johncohn/alia_blinky/SOLDER.md

# Soldering and Gluing the Alia Blinky PCB

This guide walks you through two assembly steps: soldering the Seeed XIAO RP2040 microcontroller onto the Alia Blinky PCB, and gluing the prop and tail diffuser covers in place. Soldering is optional — the board also works with the microcontroller plugged in via socket headers — but soldering it down gives a more secure, permanent connection.

**Time:** ~20 minutes  
**Skill level:** Beginner-friendly

## What You Need

- Alia Blinky PCB
- Seeed XIAO RP2040 (or compatible board)
- 2× 7-pin male header strips (usually included with the XIAO)
- Soldering iron (300°C / 570°F)
- Solder (rosin-core recommended)
- Isopropyl alcohol (IPA) + cotton swabs for cleanup
- Flush cutters + safety glasses for trimming pins
- Kapton or masking tape (optional, helps hold the chip while soldering the back)

## Step 1: Get familiar with the PCB

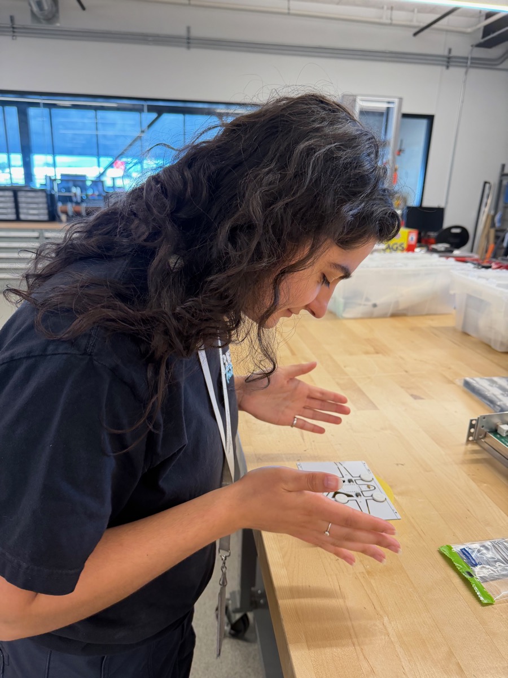
[picture p6: images/soldering/IMG_4557.jpeg]
Person examining the PCB


Take a moment to look over the PCB. The center area is where the microcontroller mounts. The large circular pads are the prop LED pads; the gold traces connect everything together.

## Step 2: Inspect the PCB component side

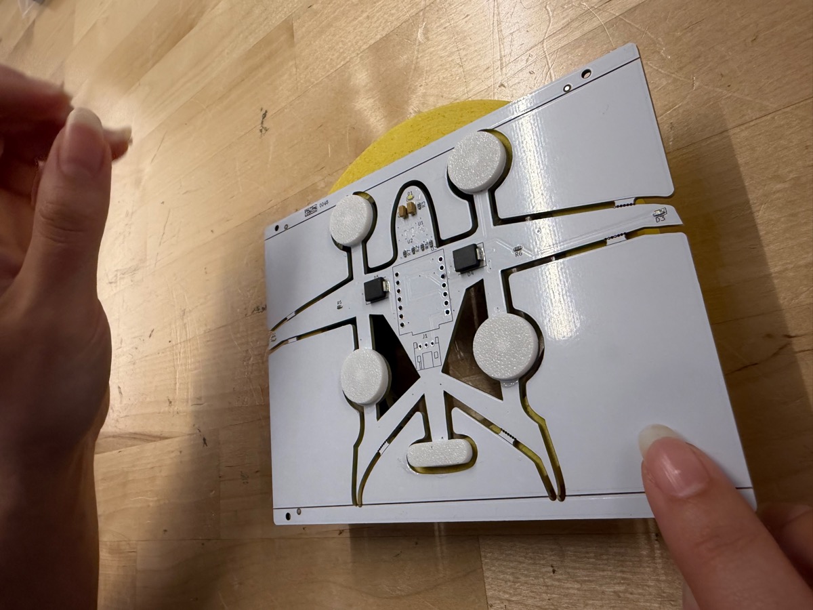
[picture p7: images/soldering/IMG_4558.jpeg]
PCB front side showing component area


The front side of the PCB has the small pre-soldered SMD components (capacitors, diodes, resistors) in the center. The two rows of through-holes flanking the center cutout are where the pin headers will go.

## Step 3: Gather your parts

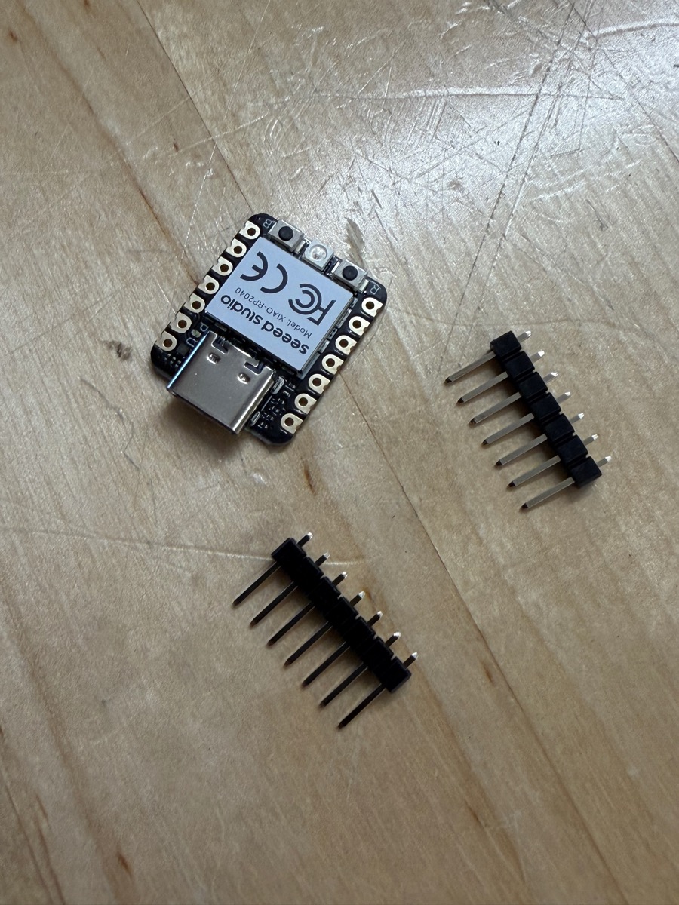
[picture p8: images/soldering/IMG_4563.jpeg]
XIAO RP2040 with two pin header strips


You need the XIAO RP2040 and two 7-pin header strips. The headers typically come packaged with the XIAO — break them to length if needed.

## Step 4: Insert the pin headers

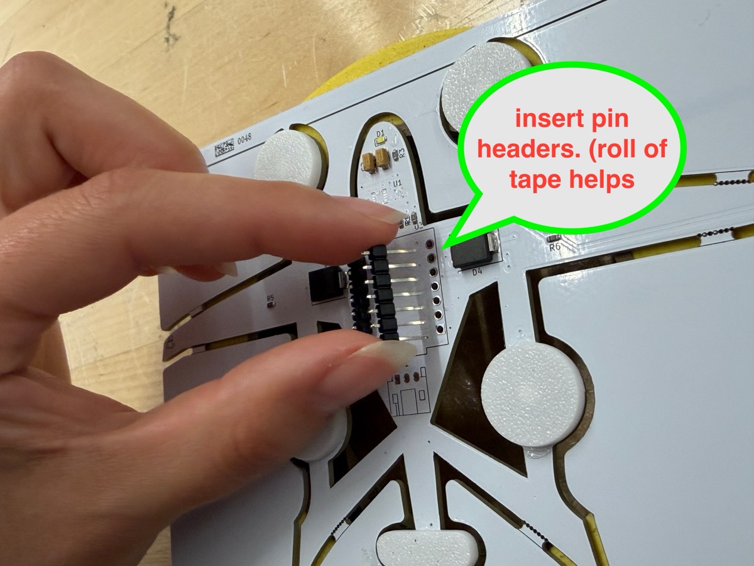
[picture p9: images/soldering/IMG_4566.jpeg]
Inserting pin headers into PCB


Insert the two pin header strips into the through-holes on the PCB (short pins down through the board, long pins up). **Tip:** resting the PCB on a roll of tape keeps it elevated so the pins don't get pushed back out while you work.

## Step 5: Pin headers seated

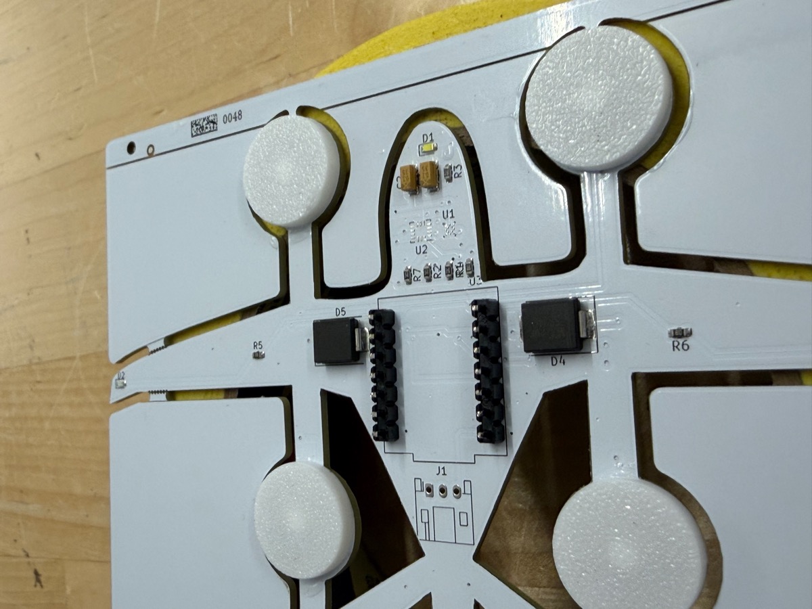
[picture p10: images/soldering/IMG_4568.jpeg]
PCB with pin headers inserted, center area visible


With both header strips inserted, you can see the two rows of pins ready to accept the microcontroller. The pre-soldered SMD components (D1, D4, D5, R5, R6, U1, U2) are visible in the center — these are already done for you.

## Step 6: Place the microcontroller — correct orientation

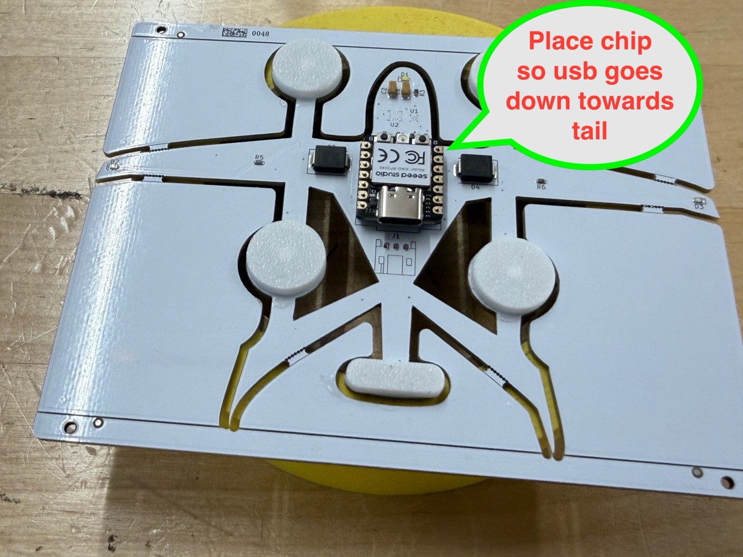
[picture p11: images/soldering/IMG_4570.jpeg]
XIAO placed on PCB, USB port pointing toward tail


Place the XIAO onto the pin headers. **The USB-C port must face toward the tail of the aircraft** (the bottom of the PCB as shown). This is critical — the pin mapping only works in this orientation.

## Step 7: Wrong orientation — don't do this

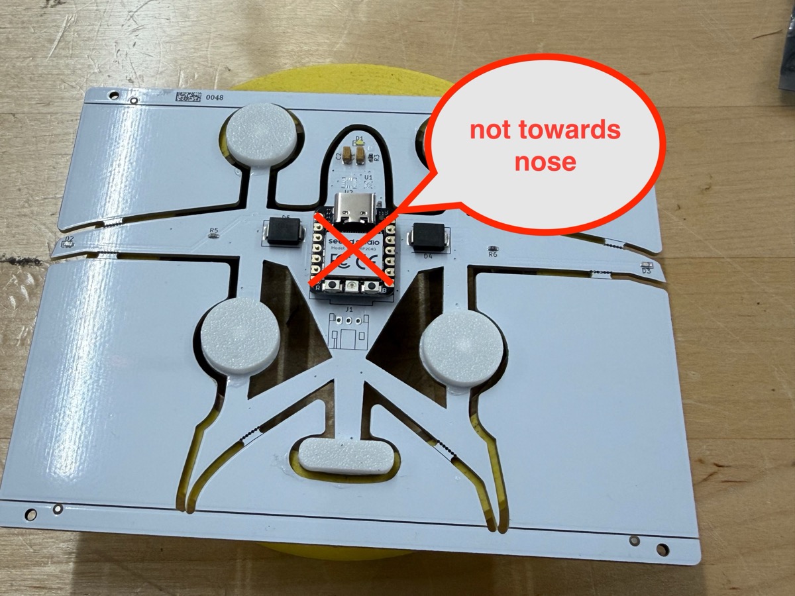
[picture p12: images/soldering/IMG_4571.jpeg]
XIAO placed backwards with red X


**Do not** place the chip with the USB port pointing toward the nose. This is the wrong orientation — the pins will be reversed and the board won't work correctly.

## Step 8: Wrong orientation — don't do this either

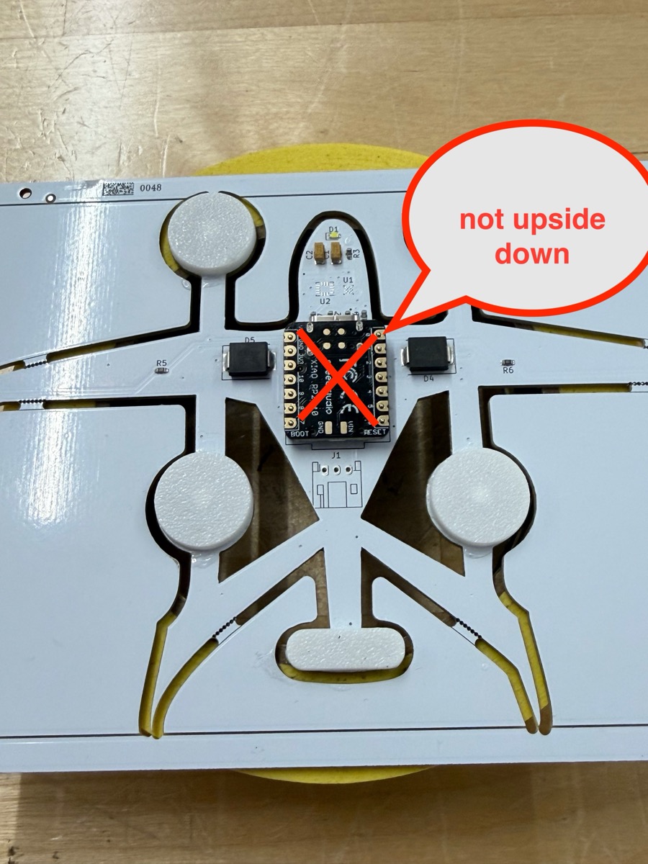
[picture p13: images/soldering/IMG_4572.jpeg]
XIAO placed upside down with red X


**Do not** place the chip upside down (component side facing down). The chip label and FCC logo should be visible from the top.

## Step 9: Turn on the soldering iron

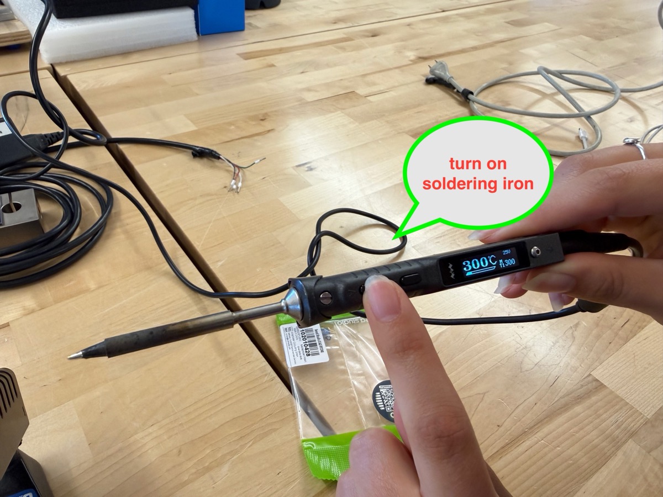
[picture p14: images/soldering/IMG_4578.jpeg]
Soldering iron powered on at 300°C


Power on your soldering iron and set it to **300°C (570°F)**. Allow it to fully heat up before starting — this usually takes 1–2 minutes.

## Step 10: Clean the tip

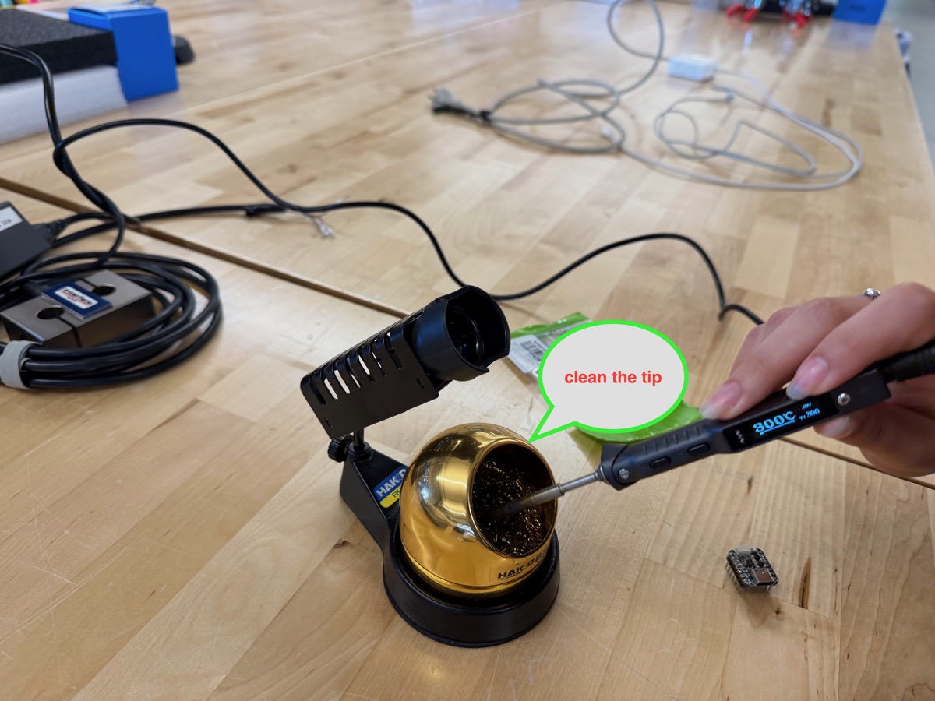
[picture p15: images/soldering/IMG_4579.jpeg]
Cleaning the iron tip in brass wool


Before soldering, clean the iron tip by wiping it in the brass wool cleaner. A clean, shiny tip transfers heat much more effectively than a dirty or oxidized one. Re-tin the tip with a small amount of fresh solder after cleaning.

## Step 11: Double-check orientation before soldering

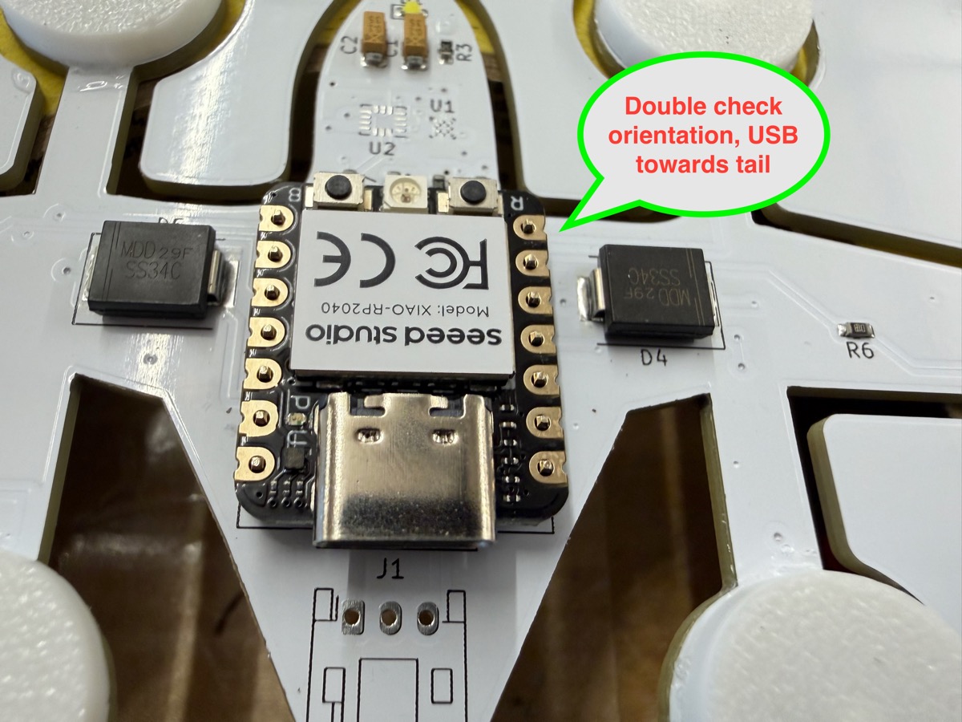
[picture p16: images/soldering/IMG_4581.jpeg]
Close-up of XIAO seated correctly, USB toward tail


Before applying any solder, do a final orientation check. The USB-C port should be pointing toward the tail. Once you solder a pin it takes effort to undo, so confirm now.

## Step 12: Solder technique — one pin first

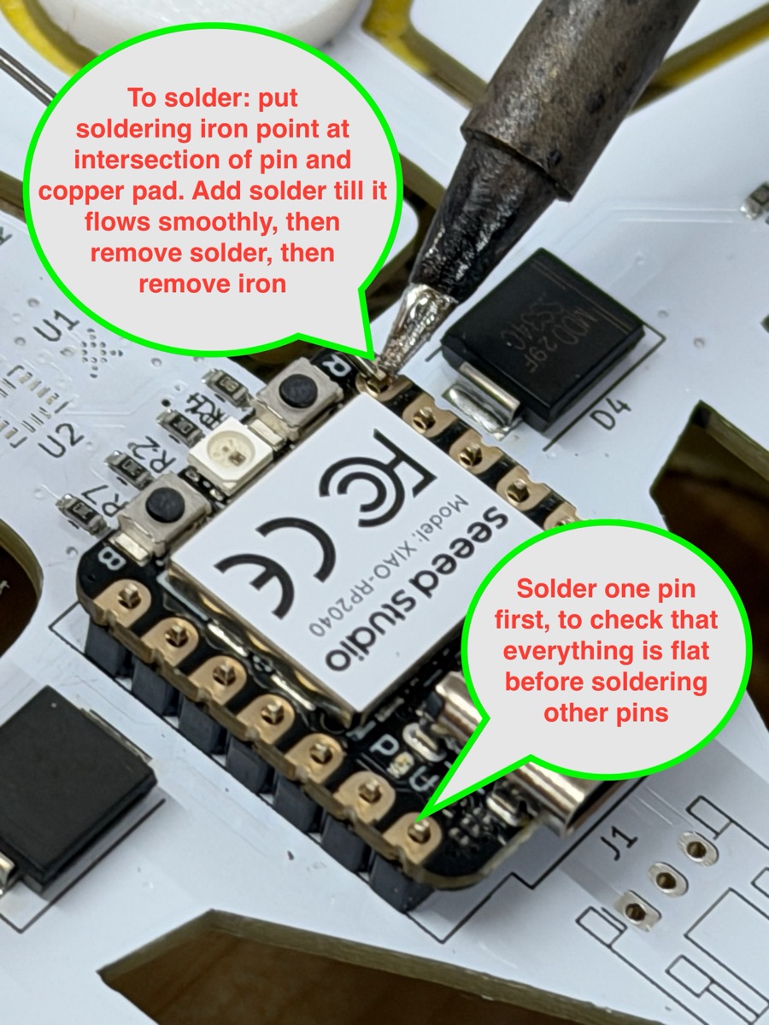
[picture p17: images/soldering/IMG_4584.jpeg]
Iron at pin/pad intersection with technique callouts


Place the iron tip at the intersection of the pin and the copper pad — touching both at the same time. Feed solder into that junction (not onto the iron itself) until it flows smoothly, then remove the solder, then remove the iron. **Start with just one pin** so you can verify everything is flat before committing to all the others.

## Step 13: Where to apply solder

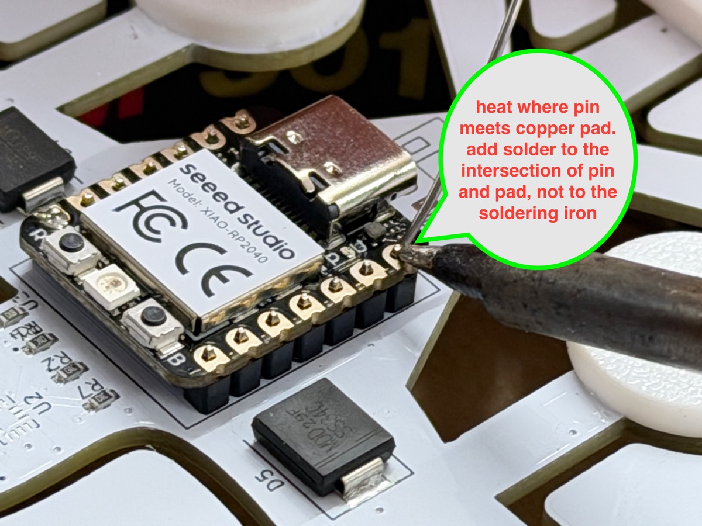
[picture p18: images/soldering/IMG_4593.jpeg]
Close-up of iron touching pin/pad junction


Heat where the pin meets the copper pad. Add solder to the intersection of the pin and pad — not to the soldering iron. The solder should flow toward the heat and wick around the pin to form a cone shape.

## Step 14: What a good joint looks like

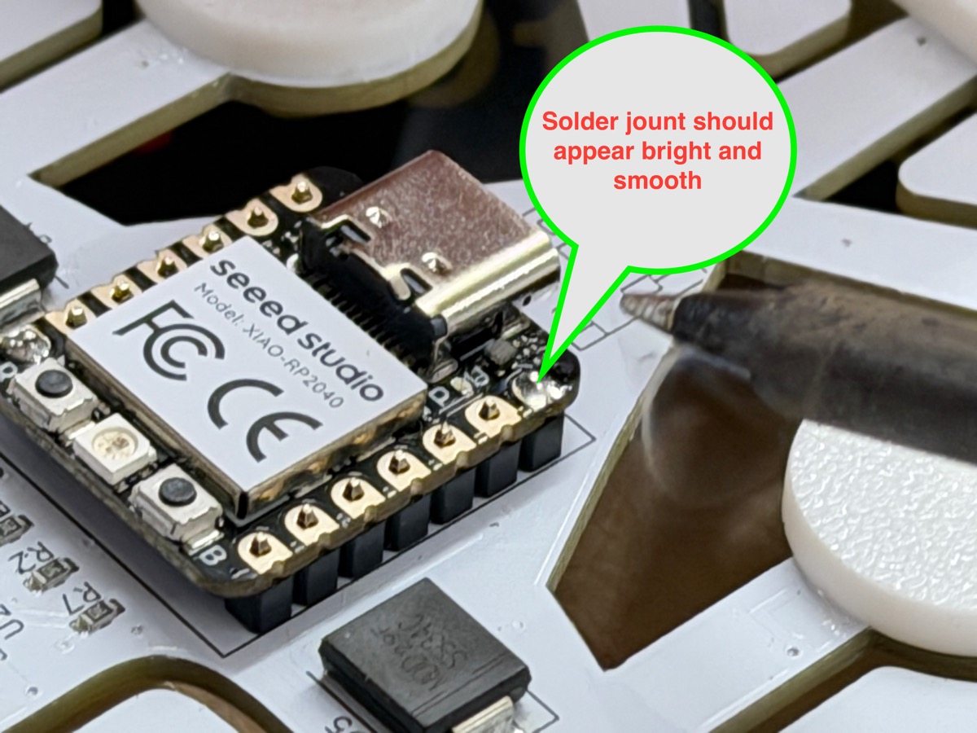
[picture p19: images/soldering/IMG_4595.jpeg]
Single bright smooth solder joint


A good solder joint is **bright and smooth**, forming a neat cone around the pin. If it looks dull, lumpy, or balled up, it's a cold joint — reheat it until the solder flows and re-wets the pad.

## Step 15: Solder one full side

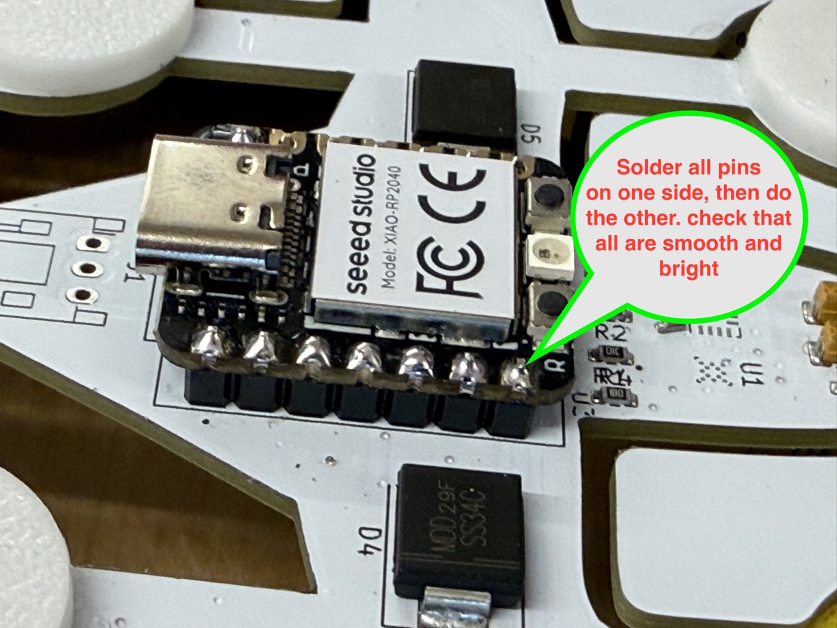
[picture p20: images/soldering/IMG_4600.jpeg]
All pins on one side soldered


Once your first pin looks good and the chip is sitting flat, solder all the remaining pins on that side. Then do the other side. Check every joint — all should be bright and smooth.

## Step 16: Watch out for solder bridges (shorts)

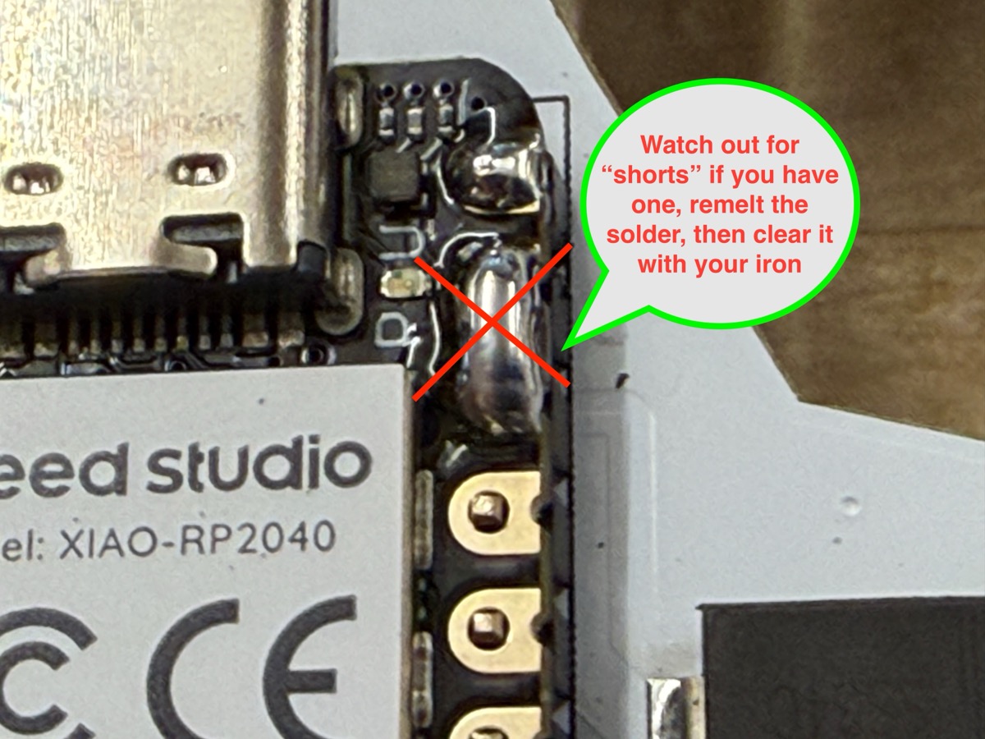
[picture p21: images/soldering/IMG_4607.jpeg]
Close-up of solder bridge between pins with red X


Watch for **solder bridges** — blobs of solder connecting two adjacent pins together. If you see one, reheat the joint until the solder melts, then drag the iron tip away to pull the exces`s solder off. You can also use solder wick to absorb it.

## Step 17: Tape the chip and flip the board

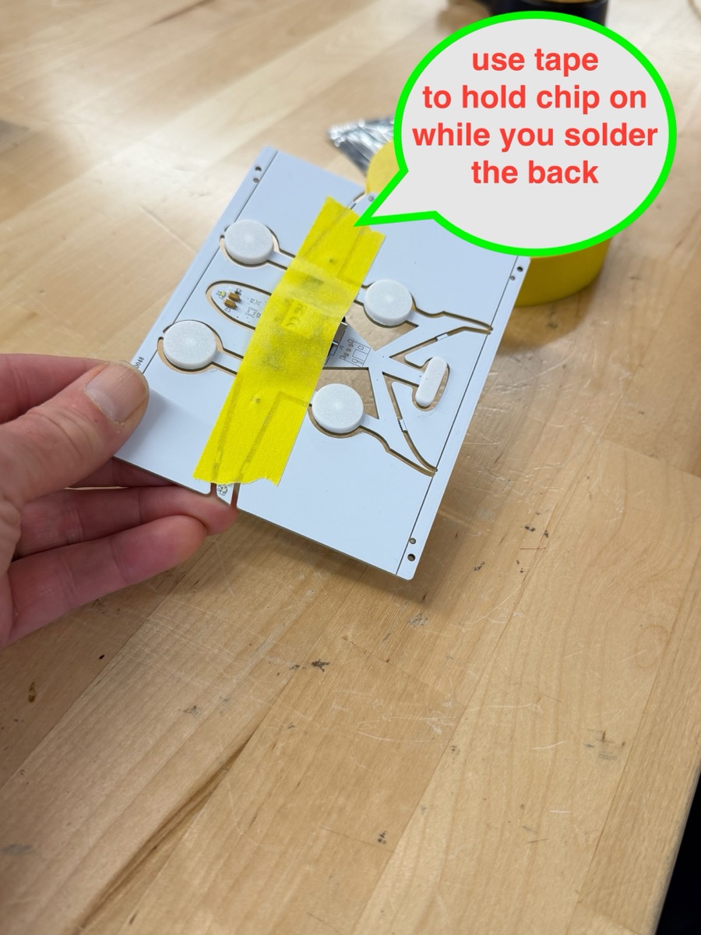
[picture p22: images/soldering/IMG_4609.jpeg]
PCB flipped over with yellow tape holding the chip


Place a strip of tape over the chip to hold it in place, then carefully flip the board over. The pin tips will now be sticking up through the back of the PCB, ready to solder.

## Step 18: Back side — pins ready to solder

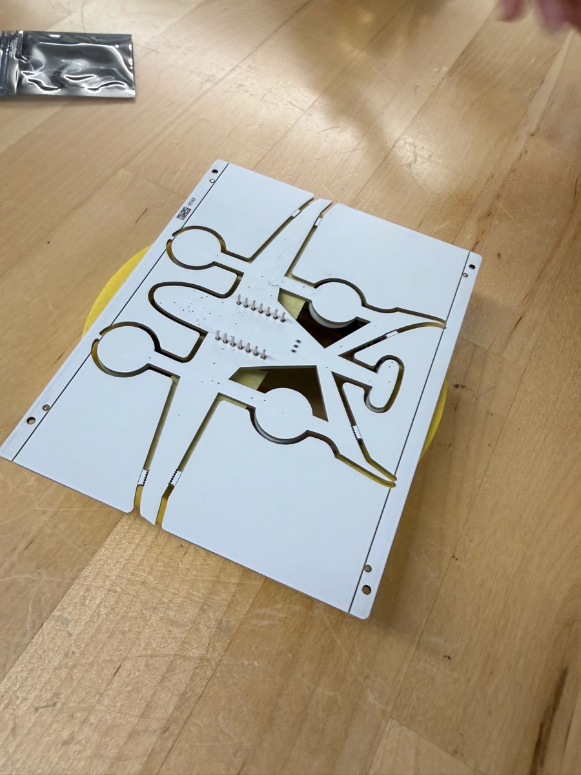
[picture p23: images/soldering/IMG_4610.jpeg]
Back of PCB with pin tips protruding through


From the back you can see the two rows of pin tips coming through the board. These are what you'll solder to secure the connection from this side.

## Step 19: Back side — solder one pin first

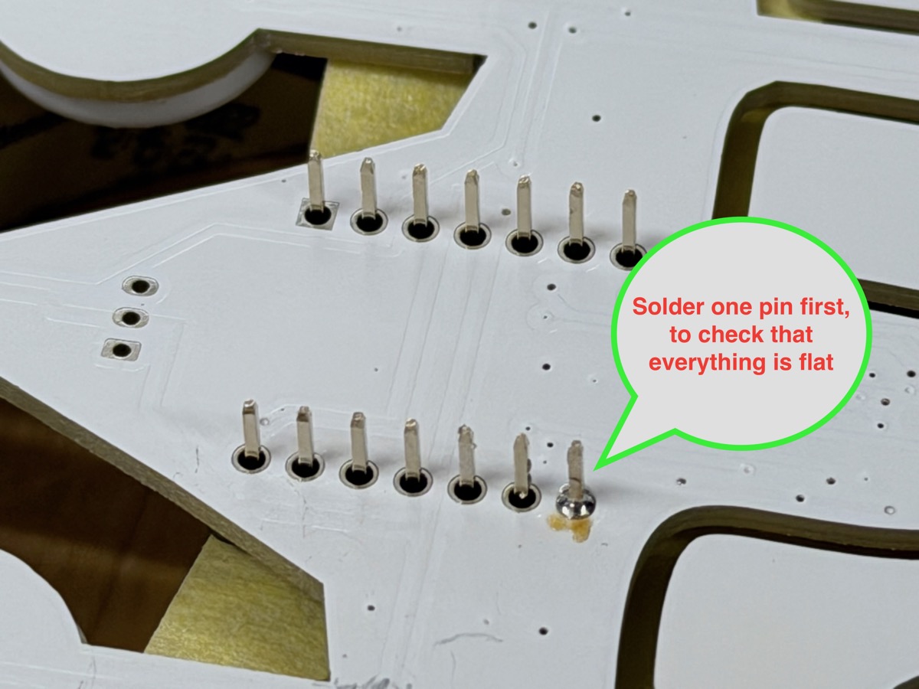
[picture p24: images/soldering/IMG_4612.jpeg]
Back of PCB, one corner pin soldered


Same technique as the front: start with just one corner pin. Solder it, then check that the chip is still sitting flat against the PCB before continuing.

## Step 20: Check flatness, then solder the opposite corner

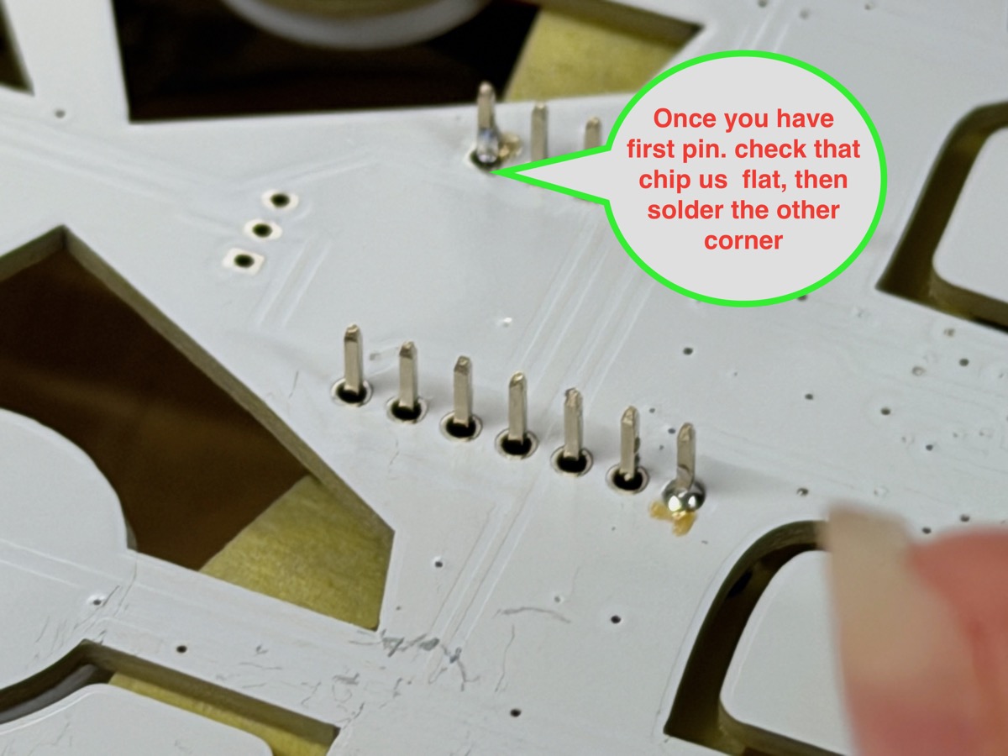
[picture p25: images/soldering/IMG_4614.jpeg]
Back of PCB, opposite corner pin now soldered


Once the first pin is done and the chip is confirmed flat, solder the diagonally opposite corner pin. These two anchors hold the chip securely in position while you finish all the remaining pins.

## Step 21: Watch out for cold joints

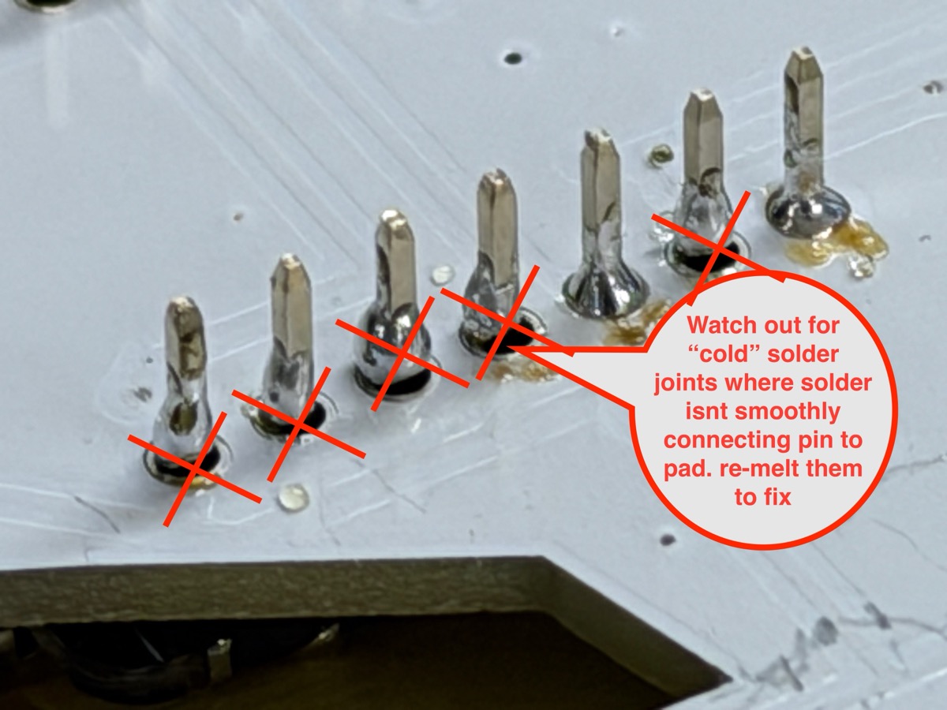
[picture p26: images/soldering/IMG_4616.jpeg]
Back pins with cold joints marked with red X


**Cold joints** look dull, grainy, or like a ball sitting on the pad rather than flowing into it. They indicate the solder didn't reach proper temperature and may not make a good electrical connection. Re-melt any cold joints and let them re-flow properly.

## Step 22: Finish all back pins

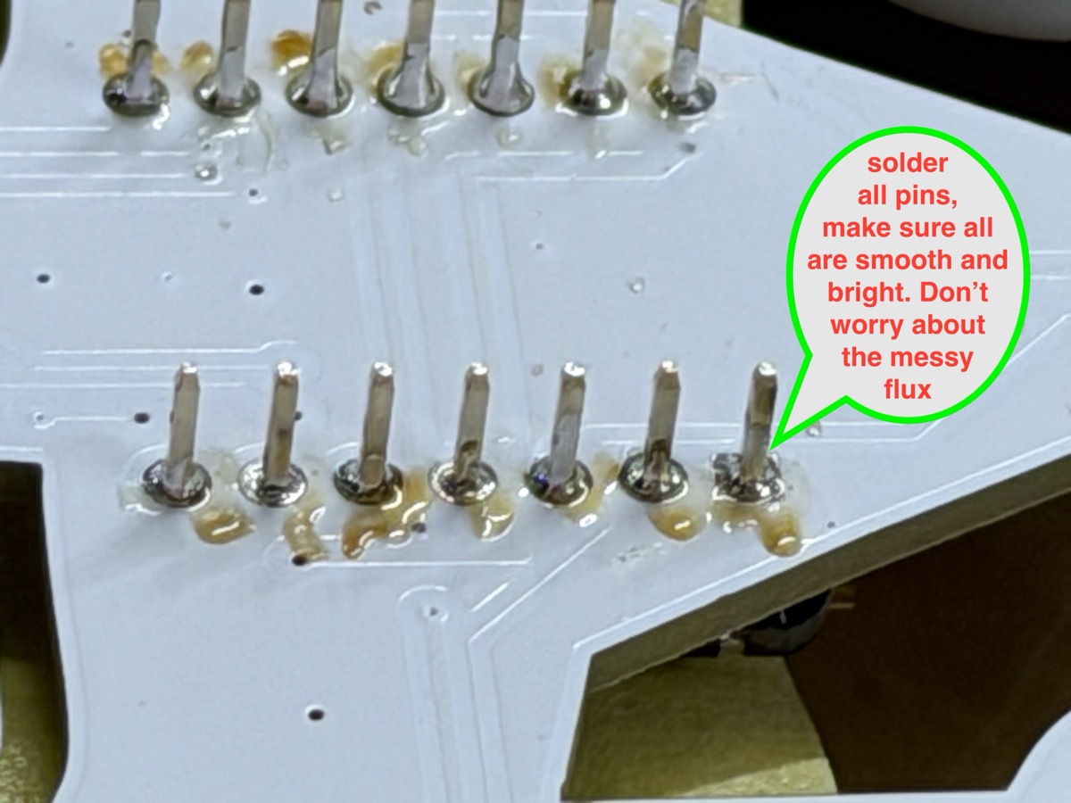
[picture p27: images/soldering/IMG_4619.jpeg]
All back pins soldered, flux residue visible


Solder all remaining pins on the back side. All joints should be smooth and bright. Don't worry about the amber/brown flux residue — that's normal and harmless, and you'll clean it off next.

## Step 23: Clean off the flux

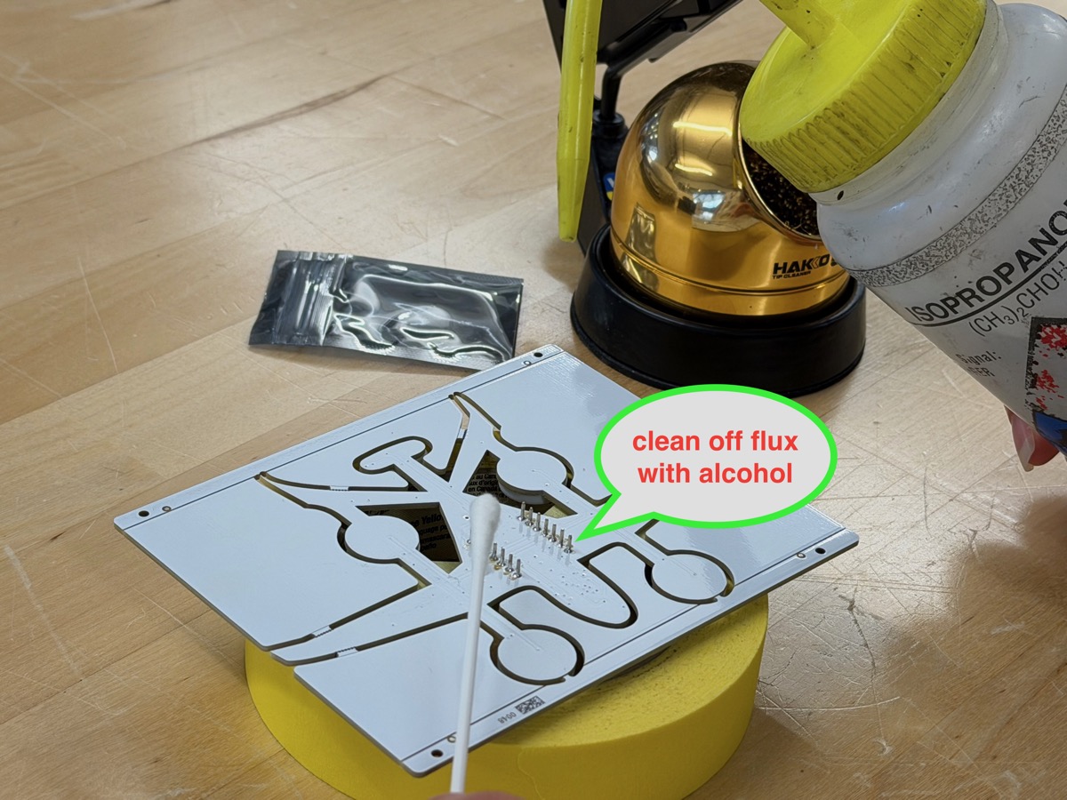
[picture p28: images/soldering/IMG_4620.jpeg]
Board being cleaned with isopropyl alcohol and cotton swab


Dip a cotton swab in isopropyl alcohol (IPA, 90%+) and scrub away the flux residue. The board will look much cleaner and it's easier to inspect your joints afterwards.

## Step 24: Trim the protruding pins

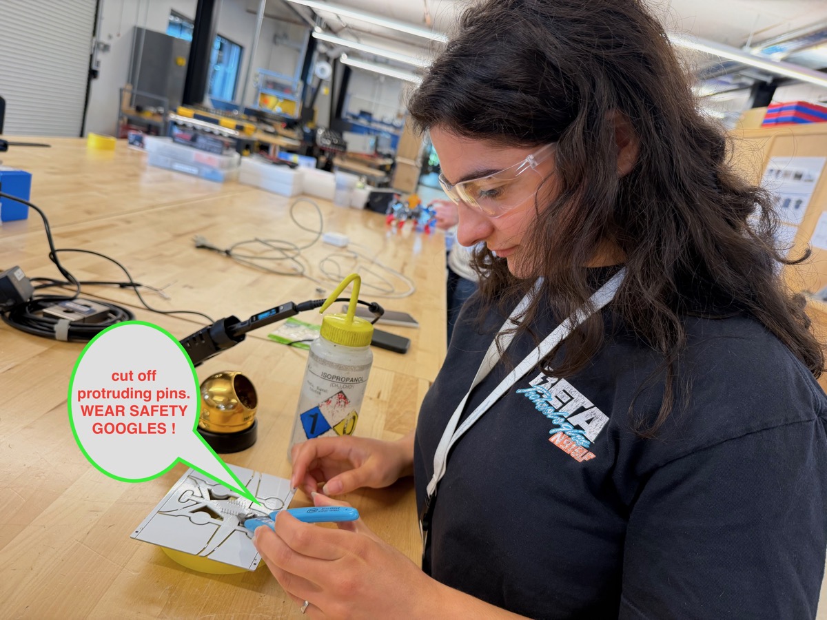
[picture p29: images/soldering/IMG_4624.jpeg]
Person trimming pins with flush cutters, wearing safety glasses


Use flush cutters to trim the pin tips down close to the solder joints. **Always wear safety glasses for this step** — the clipped pin ends can fly off at speed and cause eye injury.

## Step 25: Done!

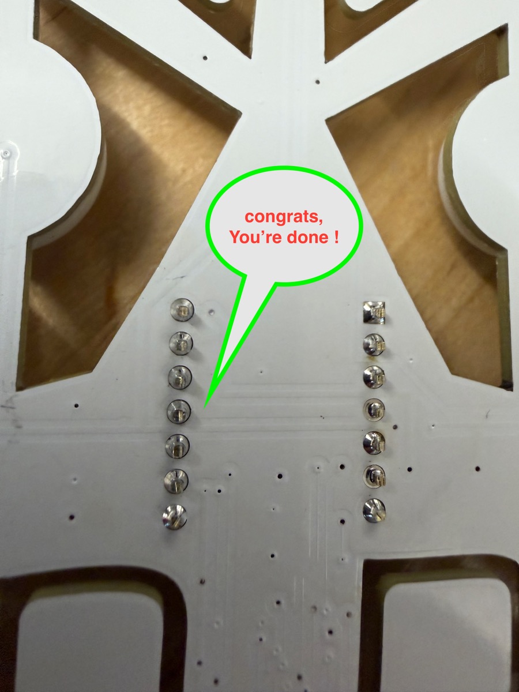
[picture p30: images/soldering/IMG_4629.jpeg]
Back of finished PCB with clean trimmed pins


Congratulations — you're done! The back of the board should show two neat rows of short, trimmed, bright solder joints. Plug in your USB-C cable, upload the firmware, and enjoy the light show.

## Troubleshooting

**LEDs don't light up at all**
- Check the serial monitor (115200 baud) — the board should print startup info on boot
- Verify the USB port is toward the tail (correct orientation)
- Inspect all solder joints under good lighting — look for any that are dull or bridged

**Some LEDs are dim or wrong color**
- Usually a cold joint on one of the data pins — reflow any suspect joints

**Board won't enumerate as USB device**
- Check for a solder bridge on the pins nearest the USB connector
- Try holding the BOOT button while plugging in to enter bootloader mode

See [TUTORIAL.md](TUTORIAL.md) for full firmware setup instructions.

# Part 2: Gluing the Prop and Tail Diffuser Covers

Once the electronics are working, glue the white diffuser covers over the prop LED rings and the tail LED strip. These soften and spread the LED light for a realistic look.

**Time:** ~15 minutes  
**Skill level:** Beginner-friendly

## What You Need

- 4 prop diffuser covers (round, white) + 1 tail diffuser cover (oval, white)
- Super glue (cyanoacrylate — Bob Smith Industries Maxi-Cure or similar extra-thick CA glue recommended)
- CA glue accelerator spray (e.g., eRockets INSTA-SET)
- Paper towel to work on — glue will bond to your table!

> **Safety:** CA glue bonds skin instantly. Keep it off your fingers and away from your eyes. Work in a ventilated area.

## Step 1: Locate the diffuser covers

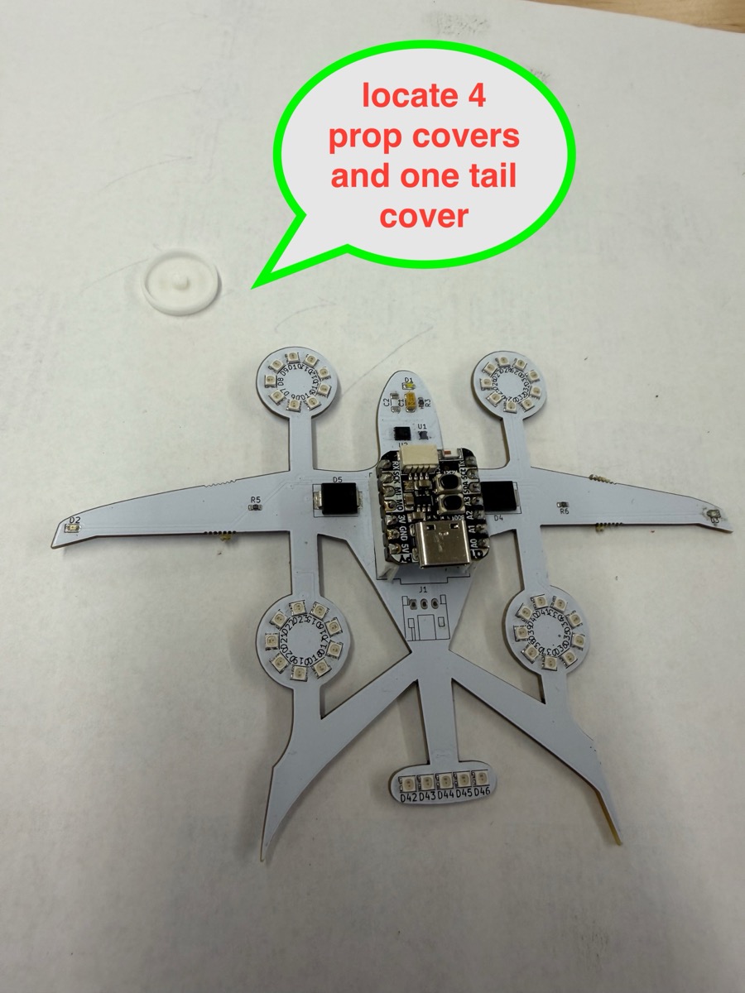
[picture p31: images/gluing/glue_2.jpeg]
Assembled PCB with one prop diffuser cover nearby


You should have 4 round prop covers and 1 oval tail cover. The round covers go over each of the 4 prop LED rings; the oval cover goes over the tail LED strip at the bottom of the PCB.

## Step 2: Get your CA glue accelerator

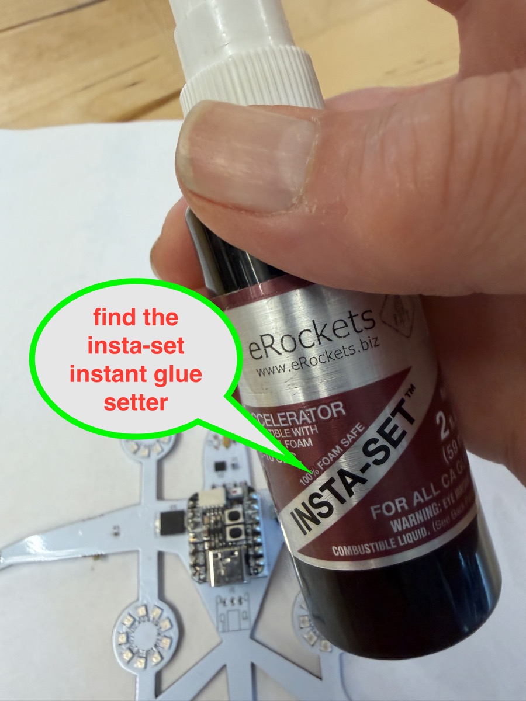
[picture p32: images/gluing/glue_5.jpeg]
Hand holding eRockets INSTA-SET accelerator bottle


Find your CA glue accelerator (INSTA-SET or equivalent). This spray is applied to the PCB first — it causes the CA glue on the cover to set almost instantly on contact, so you get a fast, strong bond without waiting.

## Step 3: Spray the prop and tail locations

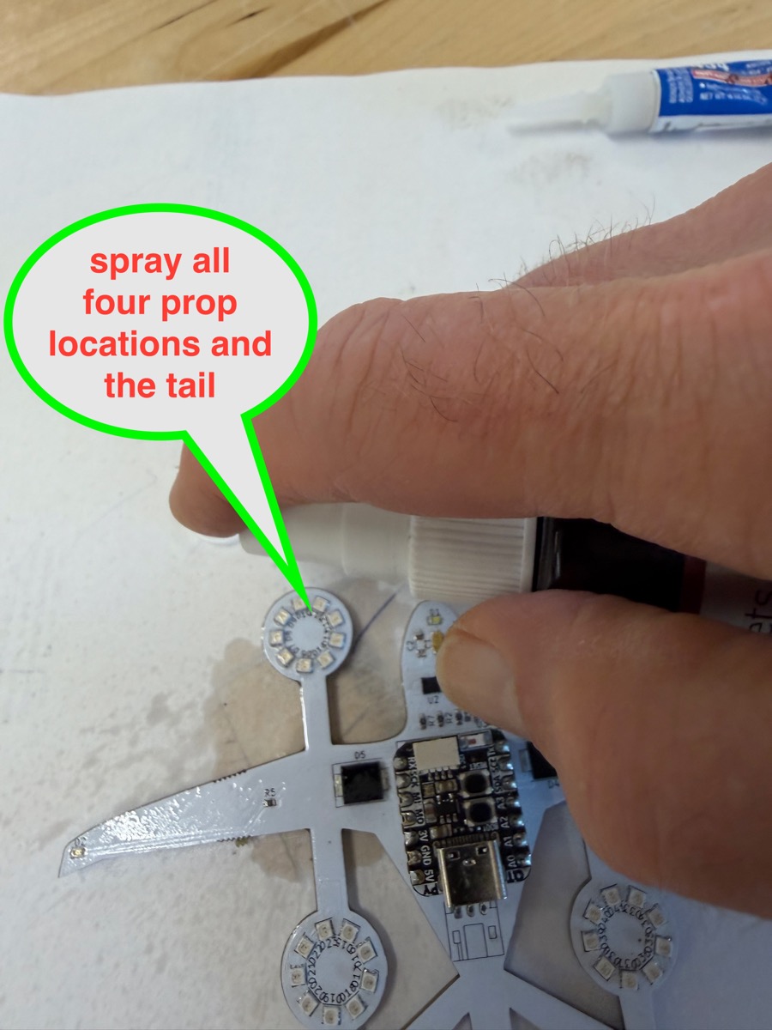
[picture p33: images/gluing/glue_7a.jpeg]
Spraying accelerator onto a prop LED ring on the PCB


Lightly spray the accelerator onto all four prop LED ring locations and the tail LED location. You don't need a lot — a quick mist is enough. Let it sit for a few seconds.

## Step 4: Get your super glue

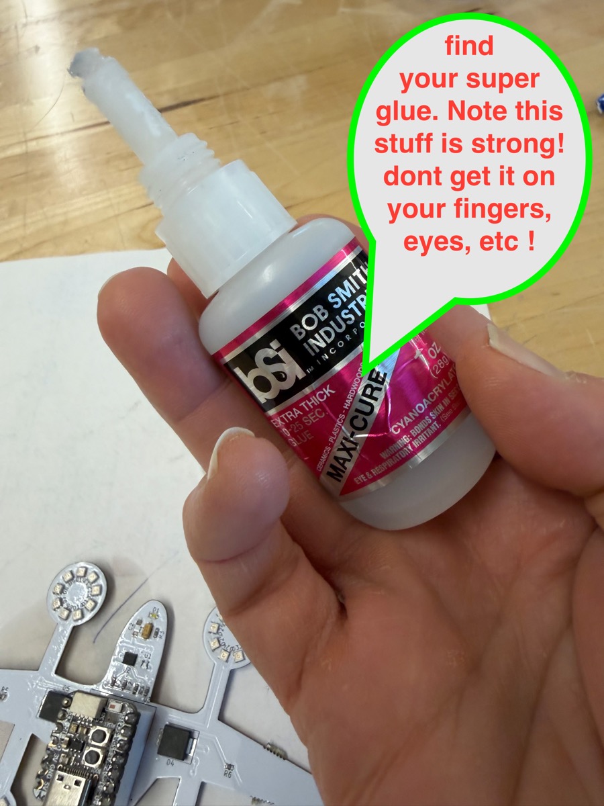
[picture p34: images/gluing/glue_7b.jpeg]
Hand holding BSI Maxi-Cure CA glue bottle


Find your super glue. Extra-thick CA glue (like BSI Maxi-Cure) works best here — it's viscous enough to stay put when you apply it to the cover. **This stuff is very strong — don't get it on your fingers or eyes.**

## Step 5: Apply glue to the prop cover posts

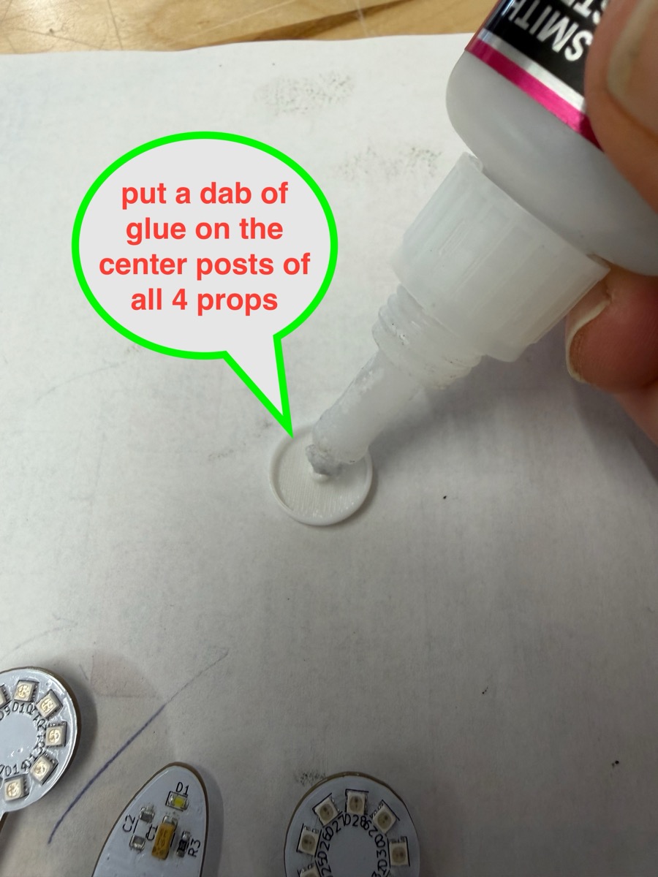
[picture p35: images/gluing/glue_7c.jpeg]
Applying a dab of CA glue to the center post of a prop cover


Put a small dab of super glue on the center post (nub) on the underside of each prop cover. Do all 4 prop covers. You only need a small amount — CA glue is very strong and a little goes a long way.

## Step 6: Place each prop cover onto the PCB

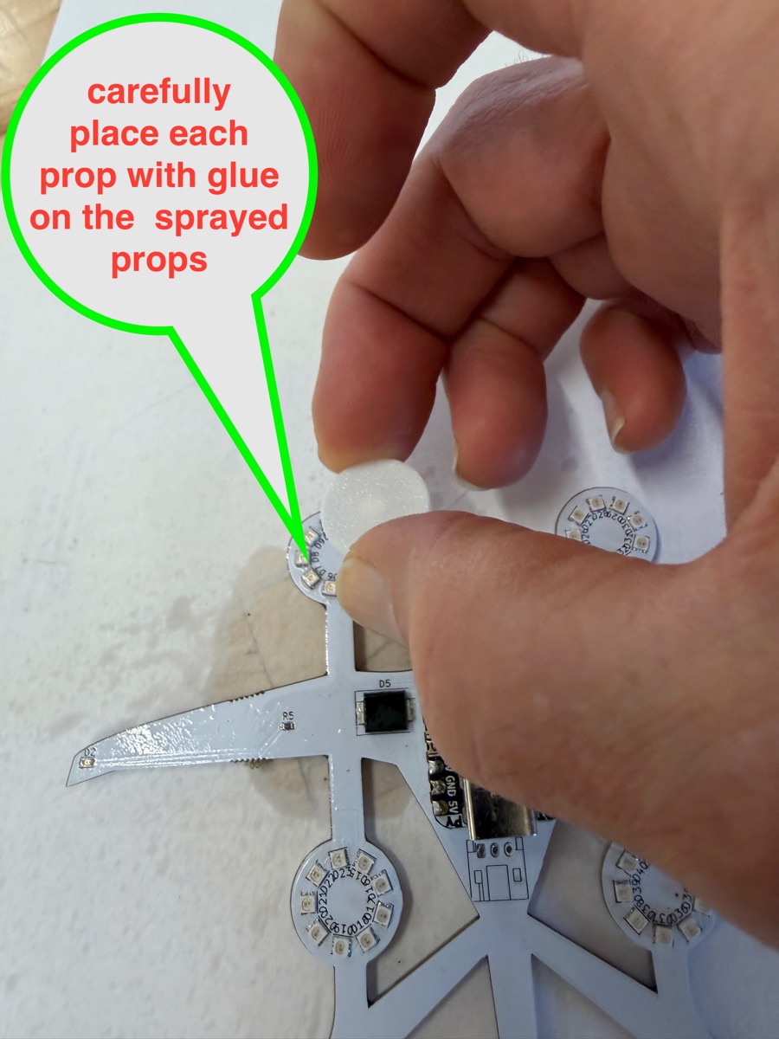
[picture p36: images/gluing/glue_8.jpeg]
Carefully pressing a prop cover onto a sprayed LED ring


Carefully lower each prop cover, glue-side down, onto its matching LED ring on the PCB. The center post should align with the center hole in the LED ring. The accelerator on the PCB will trigger the glue to set on contact.

## Step 7: Press down for 15 seconds

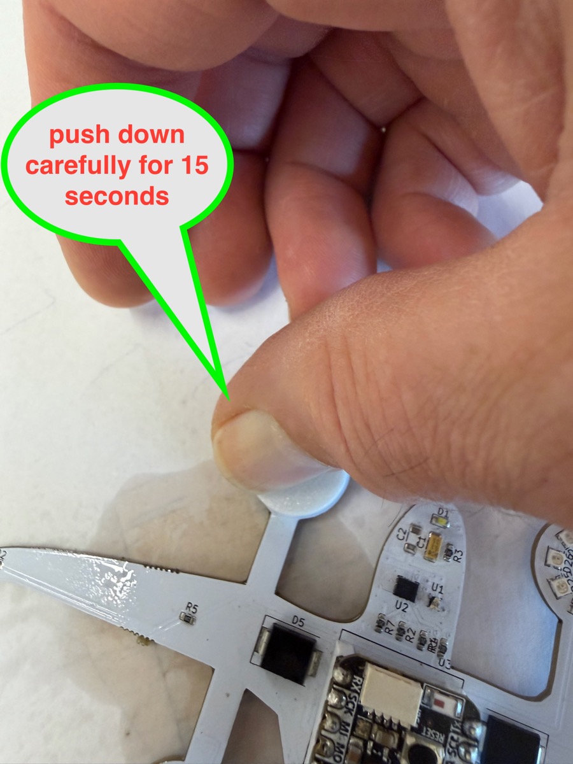
[picture p37: images/gluing/glue_10.jpeg]
Thumb pressing down firmly on a prop cover


Press each cover down firmly for about 15 seconds to ensure full contact and a strong bond. The CA glue + accelerator combination sets fast, but holding it longer ensures a solid joint.

## Step 8: Check your work

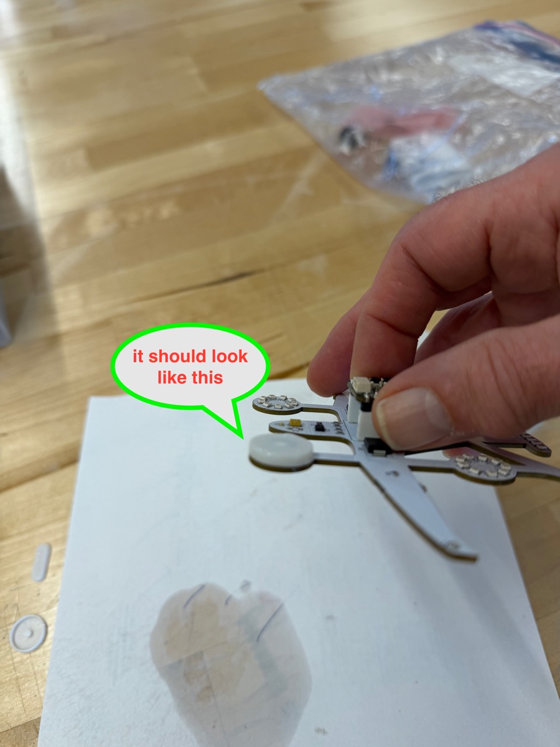
[picture p38: images/gluing/glue_17.jpeg]
PCB held up showing two prop covers attached, tail cover visible


After attaching all 4 prop covers, it should look like this — covers sitting flat and flush on each LED ring. If a cover feels loose, apply a small drop of CA glue around the edge and press again.

## Step 9: Apply glue to the tail diffuser edge

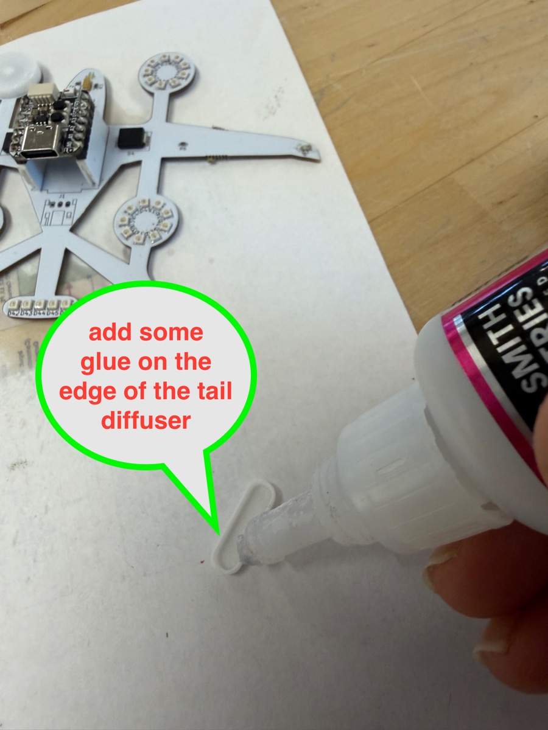
[picture p39: images/gluing/glue_19.jpeg]
Applying CA glue to the edge of the tail diffuser cover


Apply a thin bead of super glue around the edge of the tail diffuser cover (the oval piece). This cover sits over the tail LED strip rather than having a center post, so edge gluing is the method here.

## Step 10: Spray the tail location and press the cover down

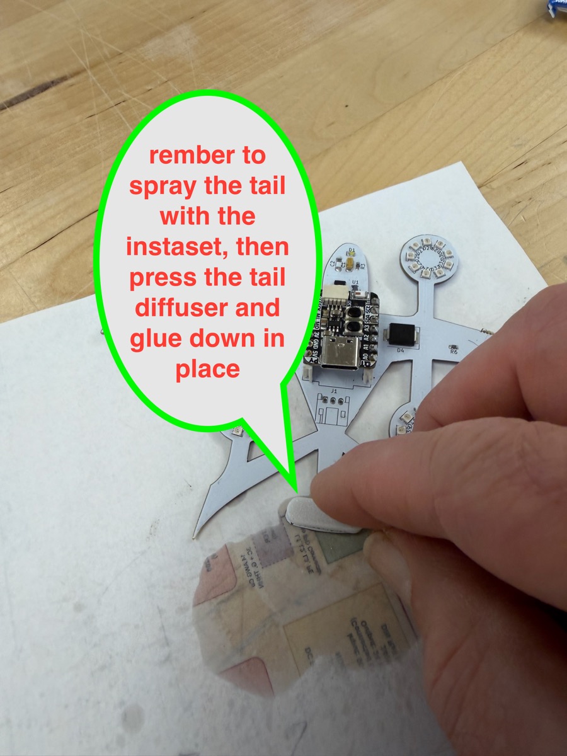
[picture p40: images/gluing/glue_20.jpeg]
Pressing tail diffuser onto the sprayed tail area of the PCB


Spray the tail LED location on the PCB with accelerator, then immediately press the tail diffuser — glue edge down — onto the tail area. The glue will set on contact with the accelerator.

## Step 11: Hold for 15 seconds

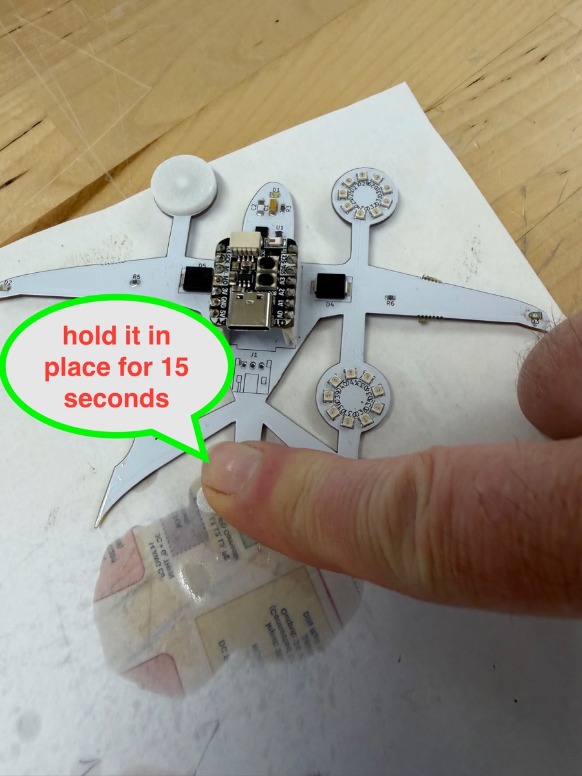
[picture p41: images/gluing/glue_21.jpeg]
Thumb holding tail diffuser in place on PCB, most props already attached


Hold the tail diffuser firmly in place for 15 seconds. Once set, the PCB assembly is complete — all 4 prop covers and the tail cover should be solidly bonded.

All done! Your Alia Blinky PCB is fully assembled and ready to install in the model.

---

## See Also

| | |
|---|---|
| [README.md](README.md) | General info about the board, hardware, and features |
| [TUTORIAL.md](TUTORIAL.md) | How to upload firmware and add custom LED patterns |
