johncohn/alia_blinky/(commit log)

2025-12-12 Initial commit: Beta Alia eVTOL LED Controller v1.0.3 Build 14
    Features:
    - FLIGHT pattern: Realistic eVTOL flight simulation with 5 phases
    - Non-linear prop acceleration/deceleration
    - Counter-rotating props with 2-LED blade pattern
    - Dynamic tail speed based on flight phase
    - Auto-cycle mode: FLIGHT, SLOW RAINBOW, FAST WHITE, RAINBOW PROPS
    - Christmas patterns mode
    - 41 WS2812B LEDs (4 props + 1 tail)
    - Seeed XIAO RP2040 microcontroller
    Hardware:
    - Props 1-4: 9 LEDs each (36 total)
    - Tail prop: 5 LEDs
    - Navigation lights: Port, Starboard, Nose
    - Pin assignments optimized for XIAO RP2040
2025-12-12 v1.1.0 Build 15: Simplified and well-commented version
    This version removes Xmas pattern complexity and adds comprehensive
    documentation to serve as a reference implementation for LED animation
    controllers.
    Major changes:
    - Removed all Christmas pattern functions (confetti, juggle, bpm, rainbowWithGlitter)
    - Removed button handling code (non-functional on BOOTSEL)
    - Removed unused modes 1-6, keeping only auto-cycle mode
    - Removed Xmas-related variables (gHue, xmasSubMode, etc.)
    Documentation improvements:
    - Added detailed header comments explaining design patterns
    - Documented FLIGHT pattern phases and timing
    - Explained non-linear motion curve implementation
    - Added inline comments throug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
2025-12-12 v1.2.0 Build 16: Modular Pattern Architecture
    Major refactoring to make it easy for others to add custom LED patterns.
    This version is optimized for extensibility and learning.
    🎯 CODE IMPROVEMENTS:
    - Added CUSTOM PATTERNS section (~line 1002) with templates and examples
    - Introduced NUM_PATTERNS constant for easy pattern count management
    - Enhanced header with step-by-step "HOW TO ADD YOUR OWN PATTERN" guide
    - Restructured loop() with clear markers for pattern addition
    - Added pattern name array with inline documentation
    - Included two example patterns (Red Wipe, Breathing Effect)
    📖 DOCUMENTATION IMPROVEMENTS:
    - Added comprehensive "Creating Custom Patterns" section to README
    - Quick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
2025-12-12 Remove outdated Christmas pattern references from README
    - Removed 'Additional Modes' section mentioning Mode 1 (Christmas patterns)
    - Removed references to Modes 2-6 (no longer exist)
    - Kept version history references (historically accurate)
    The code now only has auto-cycle mode with 4 patterns:
    FLIGHT, SLOW RAINBOW, FAST WHITE, RAINBOW PROPS
2025-12-12 Add comprehensive Getting Started Tutorial to README
    Added extensive 5-part tutorial covering complete workflow from
    installation to advanced customization.
    📚 TUTORIAL SECTIONS:
    Part 1: Setting Up Development Environment
    - Installing Arduino IDE 2.x
    - Installing Seeed XIAO RP2040 board support
    - Installing Adafruit NeoPixel library
    - Downloading and opening the code
    - First upload to board
    Part 2: Adding Your First Custom Pattern
    - Complete walkthrough with RED PULSE example
    - Step-by-step: write function, update count, add to cycle
    - Includes full working code example
    - Upload and testing instructions
    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
2025-12-12 Simplify language and add PCB design files
    LANGUAGE UPDATES:
    - Removed overly enthusiastic phrasing ("Easy to customize!")
    - Simplified credits section to be more professional
    - Toned down boastful language throughout
    CREDITS SIMPLIFIED:
    - Created by: John Cohn, PhD (December 2024)
    - Contact: jcohn@beta.team | johncohnvt@gmail.com
    - Developed with major assistance from Anthropic Claude
    - Added invitation for feedback
    HARDWARE FILES ADDED:
    - alia_blinky_kicad.zip (460KB) - Complete KiCad PCB design files
    - Added "Hardware Design Files" section in README
    - References the KiCad archive for custom PCB creation
    Updated both README.md and Alia_4_v9.ino headers for consistency.
2025-12-12 Simplify README and create separate TUTORIAL.md
    MAJOR REORGANIZATION:
    README.md (SIMPLIFIED):
    - Reduced from ~880 lines to ~150 lines
    - Quick start focused on Arduino IDE (with CLI alternatives)
    - Essential info only: features, setup, hardware, customization
    - Links to TUTORIAL.md for detailed instructions
    - More professional, less verbose
    TUTORIAL.md (NEW):
    - Complete 5-part tutorial moved from README
    - Comprehensive step-by-step guide
    - Includes both Arduino IDE and CLI instructions
    - Pattern creation examples
    - Tips, tricks, and advanced techniques
    FOCUS CHANGES:
    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
2026-01-23 Add multi-board support with automatic detection
    Major enhancements:
    - Added support for 4 boards with auto-detection:
    * Seeed XIAO RP2040
    * Adafruit QT Py RP2040
    * Seeed XIAO ESP32-S3
    * Adafruit QT Py ESP32-S3 (no PSRAM)
    - Automatic GPIO pin mapping based on board type
    - Same PCB works with all boards (TX, RX, SCK, MISO pins)
    - Updated README with complete board support documentation
    - Cleaned up debug output and startup tests
    Technical changes:
    - Compiler flag detection for board auto-selection
    - Pin mapping table for all 4 boards
    - Updated CLI commands for each board variant
    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
2026-03-29 Fix XIAO RP2040 WS2812B pin: MISO is GPIO4, not GPIO3
    PIN_SPI0_MISO=4 per arduino-pico variant file; GPIO3 is MOSI.
    Also disable Wire.begin() to avoid potential PIO conflicts on RP2040,
    add USB CDC serial wait, and add boot-time LED hardware test.
    [Alia_blinky_esp32.ino]
2026-06-15 Fix accidental edits and update stale line numbers in TUTORIAL.md
    - Remove accidental 'awwwwwwwwwwwwwwwwww' text from TUTORIAL.md
    - Remove accidental 'claude' text from LICENSE
    - Update filename references from Alia_4_v9.ino to Alia_blinky_esp32.ino
    - Update all stale line number references to match current .ino
2026-06-19 Add soldering guide with annotated photo walkthrough
    Add SOLDERING.md with 25 step-by-step photos covering pin header
    insertion, chip orientation, soldering technique, troubleshooting
    common issues (shorts, cold joints), cleanup, and pin trimming.
    Images stored in images/soldering/. Link added to README.
2026-06-19 Add backup, old tutorial, and motor test simulator files
2026-06-19 Update TUTORIAL.md
    -Seeed Studio XIAO RP2040 board package install instruction added
    -Added extra step to ensure the Seeed Studio XIAO RP2040 board is selected before clicking upload
2026-06-22 Rename SOLDERING.md to SOLDERING_AND_GLUING.md and add gluing section
    Add Part 2 gluing guide with 11 annotated photos covering prop and
    tail diffuser cover attachment using CA glue and accelerator spray.
    Images stored in images/gluing/. README link updated.
2026-06-22 Resize images to max 1200px for PDF compatibility
    Reduced all soldering and gluing images from ~75MB to ~7.6MB total
    using sips (max 1200px, 75% JPEG quality).
2026-06-22 Compact SOLDERING_AND_GLUING.md for shorter PDF output
    Replace full-width markdown images with 320px HTML img tags and
    remove horizontal rules between steps so multiple steps fit per page.
2026-06-22 Add SOLDERING_AND_GLUING.pdf
2026-06-22 Add QR codes to README and cross-reference all three docs
    - Generate QR code PNGs for TUTORIAL.md and SOLDER.md
    - Add QR codes to README key documents table
    - Add See Also section to SOLDER.md pointing to README and TUTORIAL
    - Add See Also section to TUTORIAL.md pointing to README and SOLDER
2026-07-27 Add QUICKSTART.md with short pattern-writing examples
    Tutorial feedback said it was too long/complicated. QUICKSTART covers
    getting the code, installing the software, and 5 copy-paste pattern
    examples (RWB, dot chase, solid rainbow props, sparkle, fire), and is
    now cross-linked from README and TUTORIAL.
    Claude-Session: https://claude.ai/code/session_01NtmDGxcSyS5H9YDVExRX9e
2026-07-27 Fold QUICKSTART.md into a streamlined TUTORIAL.md
    Consolidate back to a single doc: condense the setup steps (now
    covers all 4 boards instead of just RP2040), and add 5 ready-to-paste
    pattern examples (RWB, dot chase, solid rainbow props, sparkle, fire)
    alongside a fuller worked walkthrough. Also fixes stale line-number
    references in README's pattern-adding summary.
    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
2026-07-27 Remove stale simulator script and orphaned backup files
    motor_test_simulator.py targeted a different, nonexistent sketch
    (Alia_blinky_flightsim.ino) with UDP/WiFi/JSON motor telemetry that
    the current Alia_blinky_esp32.ino has no code to send or receive.
    TUTORIAL.md.old and the .ino.backup_* file were unreferenced leftovers
    from earlier edits.
    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
2026-07-27 Drop the Arduino CLI alternative to simplify setup instructions
    One path through setup (Arduino IDE only) is easier to follow than
    maintaining IDE + CLI steps in parallel.
    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
2026-07-27 Add PDF exports of README and TUTORIAL, refresh SOLDER PDF
    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
2026-07-28 Rename sketch to Alia_blinky.ino, add editable CUSTOM pattern slot
    Rename drops the now-inaccurate "_esp32" suffix since the sketch
    supports 4 boards across two architectures. Docs updated to match.
    Add a 5th auto-cycle pattern, CUSTOM (case 4, customPattern()),
    already fully wired in with a simple default (pixel-by-pixel color
    wipe through red/green/blue). It's meant to be edited directly -
    copying a sample pattern's body into it requires no other changes
    to NUM_PATTERNS, the switch, or subModeNames.
    TUTORIAL.md restructured around that: Part 2 is the easy path (copy
    a sample into customPattern() and test), Part 3 is the full 4-edit
    recipe for adding an additional pattern from scratch. Ad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
2026-07-28 Lowercase the sketch filename to match the repo/folder name exactly
    Arduino's toolchain (IDE and arduino-cli) expects a sketch's main .ino
    to match its containing folder's name, case included. The GitHub repo
    and git-clone folder are both "alia_blinky" (lowercase), so the sketch
    is now alia_blinky.ino - this avoids Arduino IDE's "move to a matching
    folder?" prompt and lets arduino-cli compile straight from the repo
    root without a workaround.
    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
    [alia_blinky.ino]
2026-07-28 Lead with a direct raw-file link instead of cloning the repo
    Most people just want the board blinking, not the PCB files or repo
    history. Setup now opens with a link straight to alia_blinky.ino
    (Save As), with the full repo clone/ZIP mentioned as the path for
    anyone who wants the KiCad files or soldering photos too.
    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
2026-07-28 Add Serial Monitor debugging tips to TUTORIAL.md
    Covers picking the right port, matching the 115200 baud rate, and
    adding Serial.print() calls to a pattern to watch values live.
    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
2026-07-28 Simplify TUTORIAL.md for readers with zero Arduino experience
    - Reorder Part 1: install the IDE before fetching code (more natural
    first-time flow), and add plain-English explanations at first use
    of jargon (board core, sketch, port, baud rate).
    - Part 2: lead with the actionable "try a sample" steps before the
    default pattern's code, and recommend Dot Chase/Sparkle as the
    easiest starting point instead of leaving all 8 as an undifferentiated
    menu.
    - Reorder the 8 samples roughly easiest to most advanced.
    - Simplify Alternating Props' ternary operators to plain if/else, and
    add a plain-English explanation of ColorHSV/gamma32 in Rainbow Props
    (Solid) - both previously assumed pr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
2026-07-28 Restructure TUTORIAL.md per feedback from a full read-through
    - Add a Windows/Mac/Linux-vs-Chromebook note (Chromebooks are hard;
    suggest sharing a laptop with another student).
    - Reorder Part 1: install the IDE, board core, and library first,
    then get the code, then open/upload - instead of interleaving.
    - Scope the board-core step to just the RP2040 (the chip used in
    this example) and drop the ESP32-S3 branch; still points to
    README.md for other supported boards.
    - Name the exact library (Adafruit_NeoPixel) instead of "the library".
    - After Upload, explain what happens next: lights start cycling
    immediately and keep running on every future power-up until
    reflashed.
    - Rename "Ve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
2026-07-28 Scope TUTORIAL.md to a single board: Seeed XIAO RP2040
    Drop the QT Py RP2040 mention so the setup path names exactly one
    board with no either/or choice. README.md remains the full reference
    for the other supported boards.
    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
2026-07-29 Restore missing Additional Boards Manager URL step in TUTORIAL.md
    This was dropped during the earlier simplification pass but is
    required - the RP2040 core is a third-party board index, not in
    Arduino's default list, so without adding this URL first, Boards
    Manager won't find "Raspberry Pi Pico/RP2040" when searching rp2040.
    Also links Seeed's own walkthrough for anyone who gets stuck.
    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
